mikesmitty/canbus-outpost/hardware/canbus-outpost/production/bom.csv

Comment | Designator | Footprint | LCSC
SS54 | D2,D6,D7,D8,D9,D10,D11,D12,D13,D14 | Library:D_SMA | C22452
TLV3202 | U6,U7,U8,U9 | Library:SOIC-8_3.9x4.9mm_P1.27mm | C129325
100nF | C1,C7,C8,C9,C11,C14,C15,C16,C20,C23,C25,C26,C27,C28,C29,C30,C31,C32,C33,C34,C35,C36,C37,C38,C39 | Library:C_0402_1005Metric | C1525
ISO7720D | U10,U12,U13,U14 | Package_SO:SOIC-8_3.9x4.9mm_P1.27mm | C486037
1R8 | R18,R19,R20,R21 | Library:R_1206_3216Metric | C15545
Green LED | D1 | Library:LED_0603_1608Metric | C965804
SERVO | J1 | Library:ServoHeader_3x04_2.54mm
USB | J9 | Library:PinHeader_1x04_P2.54mm_Vertical
10K | R2,R3,R8,R10 | Library:R_0402_1005Metric | C25744
15pF | C2,C5 | Library:C_0402_1005Metric | C1548
SN65HVD230 | U4 | Library:SOIC-8_3.9x4.9mm_P1.27mm | C12084
Blue LED | D15 | Library:LED_0603_1608Metric | C965807
1K | R1,R7,R11,R15,R17,R30,R31,R32,R33,R34,R37,R39,R41 | Library:R_0402_1005Metric | C11702
W25Q32JVSS | U1 | Library:SOIC-8_5.3x5.3mm_P1.27mm | C82344
1uF | C12 | Library:C_0603_1608Metric | C15849
3.24K | R9 | Library:R_0402_1005Metric | C11457
330K | R14,R16,R38,R40,R42 | Library:R_0402_1005Metric | C25778
EL3H4(A)(TA)-G | U15 | Package_SO:SOIC-4_4.55x2.6mm_P1.27mm | C42384998
BUTTON | SW1,SW2 | Library:SW_SPST_PTS810 | C139797
220uF | C10,C18,C22 | Library:CP_Elec_6.3x7.7 | C7471881
GPIO | J14 | Connector_PinHeader_2.54mm:PinHeader_1x08_P2.54mm_Vertical
L78L05_SO8 | U11 | Package_SO:SOIC-8_3.9x4.9mm_P1.27mm | C7543
3.3uH | L1 | Library:L_pol_2016 | C42411119
4.7uF | C3,C4 | Library:C_0402_1005Metric_small_pads | C23733
27R | R4,R5 | Library:R_0402_1005Metric | C25100
RJ45 | J10,J13 | Library:RJ45_Amphenol_54602-x08_Horizontal | C3000197
RP2350A | U2 | Library:QFN-60-1EP_7x7mm_P0.4mm_EP3.4x3.4mm | C42411118
BOOSTER | J3 | Library:PhoenixContact_MC_1,5_2-G-3.5_1x02_P3.50mm_Horizontal
10uF | C19,C21 | Library:C_0805_2012Metric | C15850
4.7uF | C6,C13 | Library:C_0402_1005Metric | C23733
VDC | J8 | Library:BarrelJack_Wuerth_694106106102_2.0x5.5mm | C319134
DCC_SIG | J2 | Library:JST_XH_S2B-XH-A_1x02_P2.50mm_Horizontal
4.7K | R36 | Library:R_0402_1005Metric | C25900
ABM8-272-T3 | Y1 | Library:Crystal_SMD_3225-4Pin_3.2x2.5mm | C20625731
5A | F1 | Library:Fuse_2920_7451Metric | C20539728
TRACK2 | J6 | Library:PhoenixContact_MC_1,5_2-G-3.5_1x02_P3.50mm_Horizontal
PWR_POS | JP3 | Jumper:SolderJumper-2_P1.3mm_Bridged_Pad1.0x1.5mm
XC6206PxxxMR | U5 | Library:SOT-23-3 | C5446
TRACK3 | J5 | Library:PhoenixContact_MC_1,5_2-G-3.5_1x02_P3.50mm_Horizontal
PWR_POS | JP1 | Connector_PinHeader_2.54mm:PinHeader_1x02_P2.54mm_Vertical
10nF | C17 | Library:C_0402_1005Metric | C15195
1N5819WS | D5 | Diode_SMD:D_SOD-323 | C191023
2.2K | R35 | Library:R_1206_3216Metric | C17948
15uH | L2 | Library:L_Changjiang_FXL0630 | C177243
TRACK1 | J7 | Library:PhoenixContact_MC_1,5_2-G-3.5_1x02_P3.50mm_Horizontal
TPS5430DDA | U3 | Library:TI_SO-PowerPAD-8_ThermalVias | C9864
33R | R6 | Library:R_0402_1005Metric | C25105
Red LED | D3 | Library:LED_0603_1608Metric | C2286
SWD | J11 | Library:PinHeader_1x03_P2.54mm_Vertical
TRACK4 | J4 | Library:PhoenixContact_MC_1,5_2-G-3.5_1x02_P3.50mm_Horizontal
PWR_NEG | JP2 | Jumper:SolderJumper-2_P1.3mm_Bridged_Pad1.0x1.5mm
