mikesmitty/canbus-outpost/hardware/canbus-outpost/54602-908LF.stp

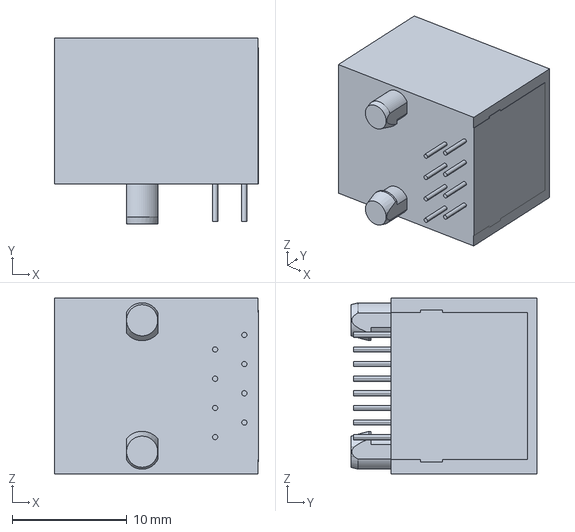
[picture p1: CAD file, 2025-09-01]
hardware/canbus-outpost/54602-908LF.stp
17.7 x 16.2 x 15.3 mm
