mikesmitty/canbus-outpost/hardware/canbus-outpost/CHANGELOG.md

# Changelog

## 0.4.0 (2026-11-13)

### Features

* add SSSB LED signal header ([7316e79](https://github.com/mikesmitty/canbus-outpost/commit/7316e792a6361132b21dae134f69fe599de6d2f2))
* add usb jack for flashing ([23d9043](https://github.com/mikesmitty/canbus-outpost/commit/23d90432513d269713aefd2f7569cba6d5ddb66d))
* initial commit ([35d93e9](https://github.com/mikesmitty/canbus-outpost/commit/35d93e993fa1c1821139c826e4c87451ff0ce4ea))

### Bug Fixes

* **hardware:** fix railcom circuits ([3e4cef5](https://github.com/mikesmitty/canbus-outpost/commit/3e4cef5458fc2f0919f649ae8a24d963a0a8edc6))
* switch from LM393 to TLV3202 for railcom signals ([46103d2](https://github.com/mikesmitty/canbus-outpost/commit/46103d206493b011c9451f2a776c54061438b2c6))
* update part rotations ([f5b980b](https://github.com/mikesmitty/canbus-outpost/commit/f5b980b29f2e95d8073f5162f05b1b61f52c5e41))
