mikesmitty/canbus-outpost/hardware/canbus-outpost/canbus-outpost.kicad_pcb

## KiCad design hardware/canbus-outpost/canbus-outpost.kicad_pcb (2026-11-13)

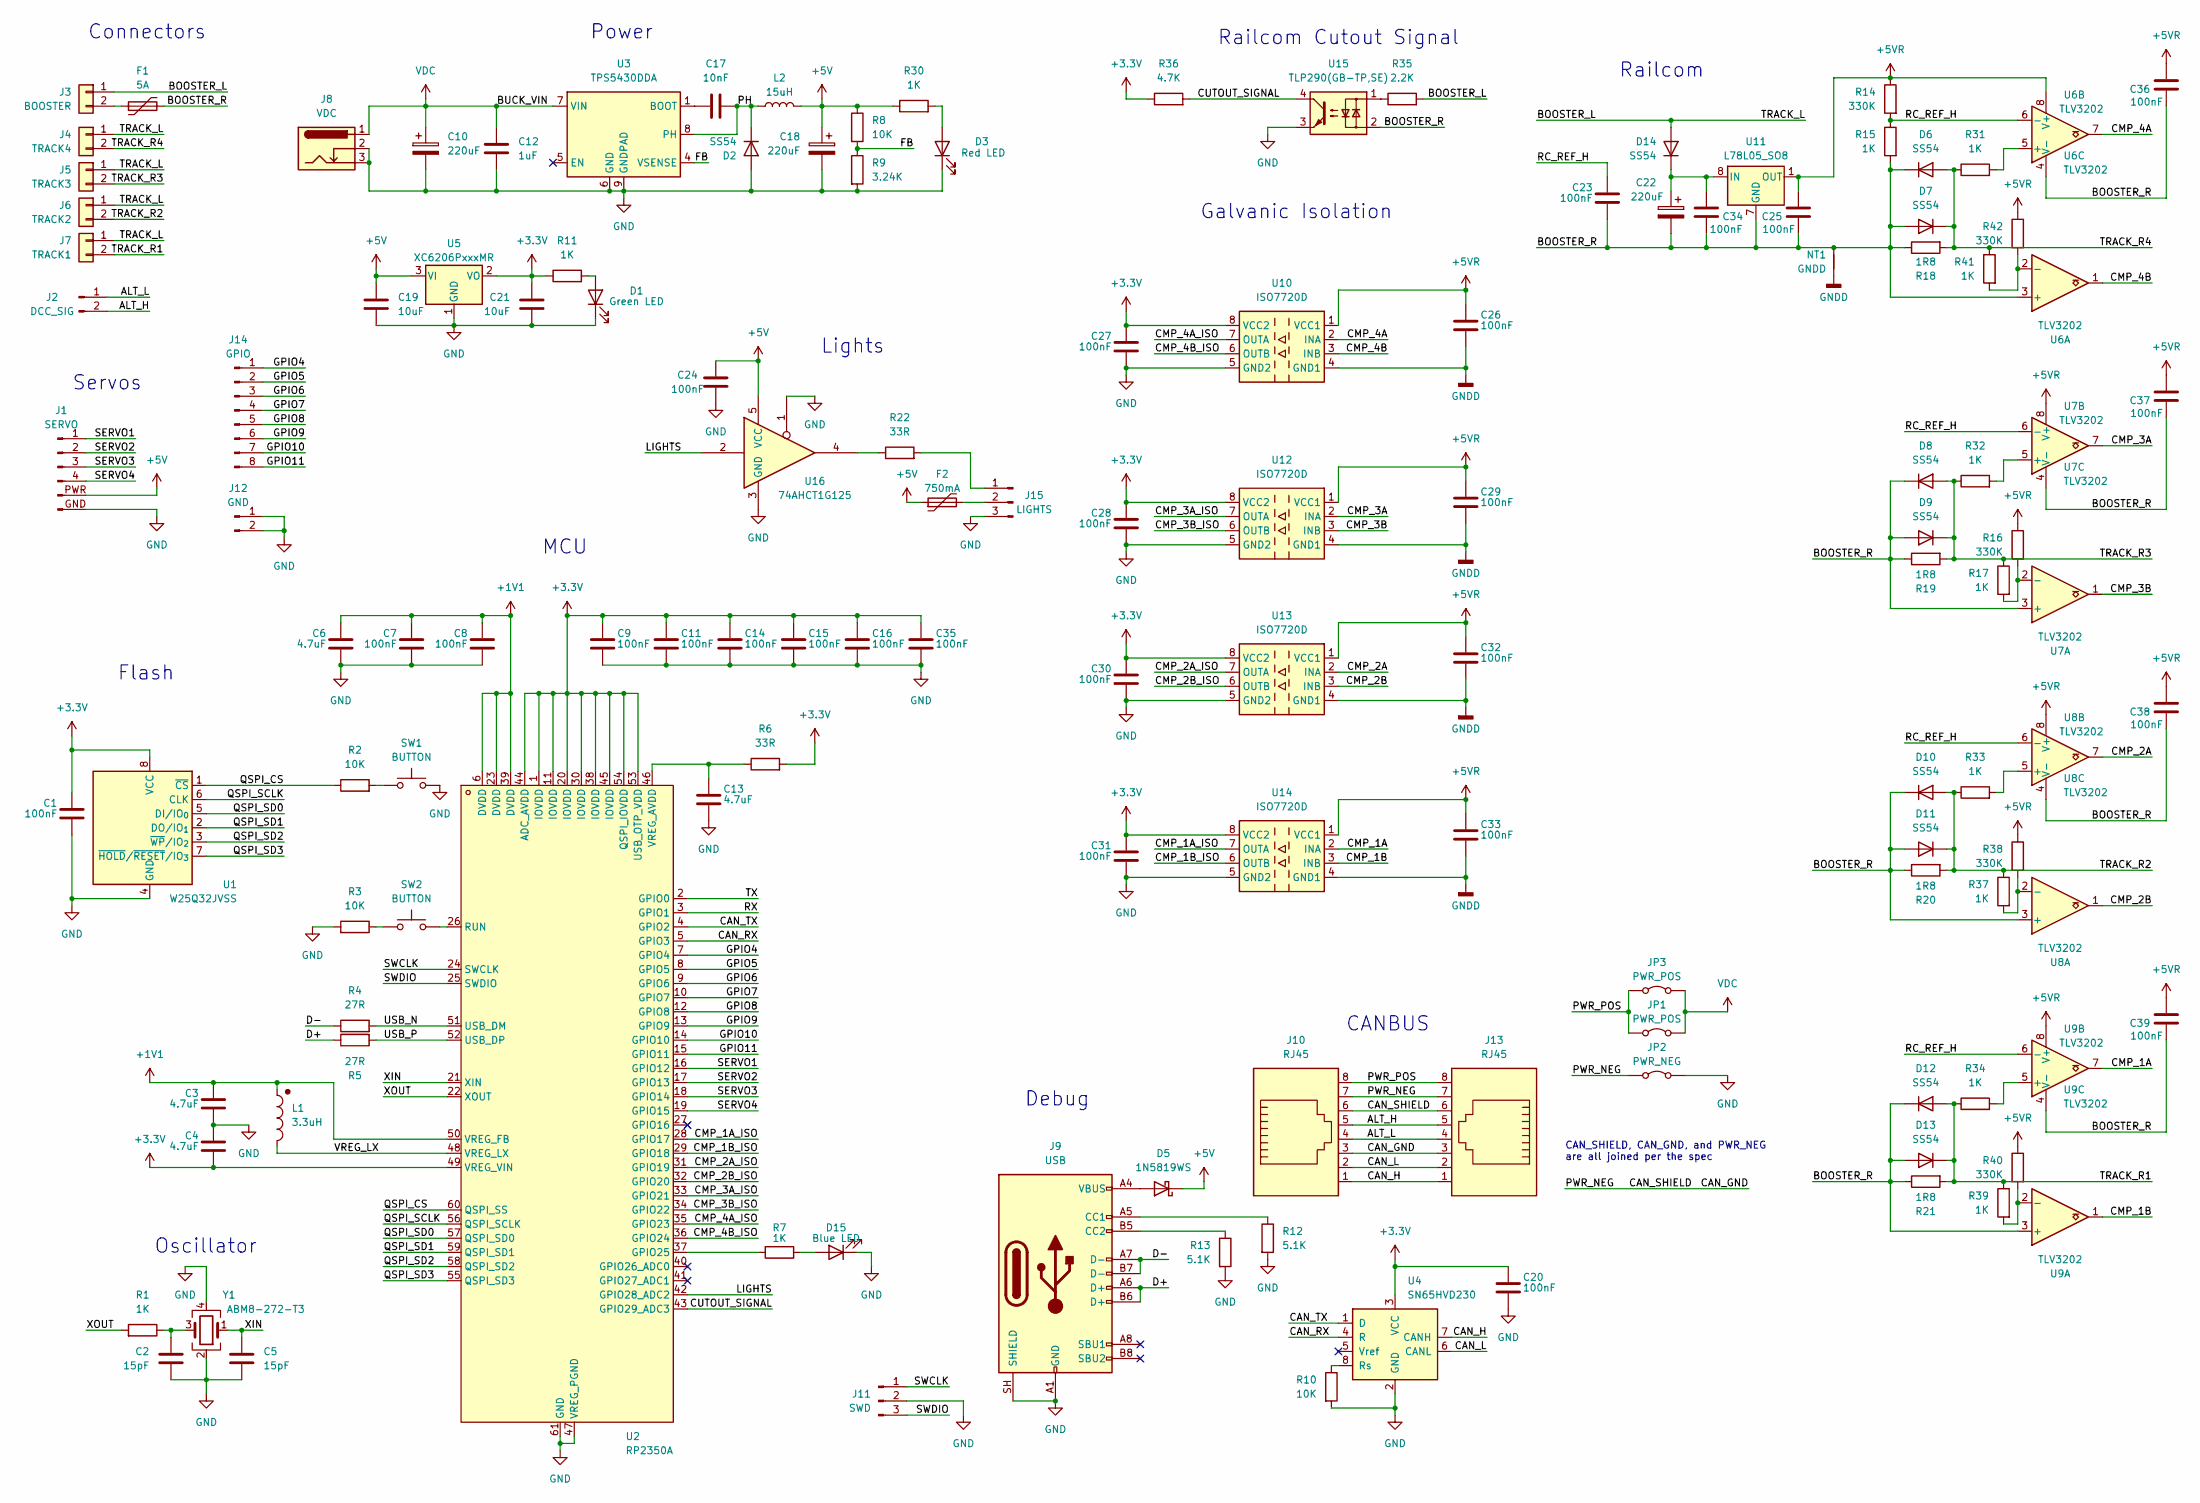
[picture p2: schematic canbus-outpost.kicad_sch, CANBUS Outpost]

Parts:
C1, C7, C8, C9, C11, C14, C15, C16, C20, C23, C24, C25, C26, C27, C28, C29, C30, C31, C32, C33, C34, C35, C36, C37, C38, C39: 100nF; C_0402_1005Metric; LCSC C1525
C2, C5: 15pF; C_0402_1005Metric; LCSC C1548
C3, C4: 4.7uF; C_0402_1005Metric_small_pads; LCSC C23733
C6, C13: 4.7uF; C_0402_1005Metric; LCSC C23733
C10, C18, C22: 220uF; CP_Elec_6.3x7.7; LCSC C7471881
C12: 1uF; C_0603_1608Metric; LCSC C15849
C17: 10nF; C_0402_1005Metric; LCSC C15195
C19, C21: 10uF; C_0805_2012Metric; LCSC C15850
D1: Green LED; LED_0603_1608Metric; LCSC C965804
D2, D6, D7, D8, D9, D10, D11, D12, D13, D14: SS54; D_SMA; LCSC C22452
D3: Red LED; LED_0603_1608Metric; LCSC C2286
D5: 1N5819WS; D_SOD-323; LCSC C191023
D15: Blue LED; LED_0603_1608Metric; LCSC C965807
F1: 5A; Fuse_2920_7451Metric; LCSC C20539728
F2: 750mA; Fuse_1206_3216Metric; LCSC C2830242
J1: SERVO; ServoHeader_3x04_2.54mm
J2: DCC_SIG; JST_XH_S2B-XH-A_1x02_P2.50mm_Horizontal
J3: BOOSTER; PhoenixContact_MC_1,5_2-G-3.5_1x02_P3.50mm_Horizontal
J4: TRACK4; PhoenixContact_MC_1,5_2-G-3.5_1x02_P3.50mm_Horizontal
J5: TRACK3; PhoenixContact_MC_1,5_2-G-3.5_1x02_P3.50mm_Horizontal
J6: TRACK2; PhoenixContact_MC_1,5_2-G-3.5_1x02_P3.50mm_Horizontal
J7: TRACK1; PhoenixContact_MC_1,5_2-G-3.5_1x02_P3.50mm_Horizontal
J8: VDC; BarrelJack_Wuerth_694106106102_2.0x5.5mm; LCSC C319134
J9: USB; USB_C_Receptacle_GCT_USB4115-03-C; LCSC C720628
J10, J13: RJ45; RJ45_Amphenol_54602-x08_Horizontal; LCSC C3000197
J11: SWD; PinHeader_1x03_P2.54mm_Vertical
J12: GND; PinHeader_1x02_P2.54mm_Vertical
J14: GPIO; PinHeader_1x08_P2.54mm_Vertical
J15: LIGHTS; PinHeader_1x03_P2.54mm_Vertical
JP1: PWR_POS; PinHeader_1x02_P2.54mm_Vertical
JP2: PWR_NEG; SolderJumper-2_P1.3mm_Bridged_Pad1.0x1.5mm
JP3: PWR_POS; SolderJumper-2_P1.3mm_Bridged_Pad1.0x1.5mm
L1: 3.3uH; L_pol_2016; LCSC C42411119
L2: 15uH; L_Changjiang_FXL0630; LCSC C177243
NT1: GNDD; NetTie-2_SMD_Pad0.5mm
R1, R7, R11, R15, R17, R30, R31, R32, R33, R34, R37, R39, R41: 1K; R_0402_1005Metric; LCSC C11702
R2, R3, R8, R10: 10K; R_0402_1005Metric; LCSC C25744
R4, R5: 27R; R_0402_1005Metric; LCSC C25100
R6, R22: 33R; R_0402_1005Metric; LCSC C25105
R9: 3.24K; R_0402_1005Metric; LCSC C11457
R12, R13: 5.1K; R_0402_1005Metric; LCSC C25905
R14, R16, R38, R40, R42: 330K; R_0402_1005Metric; LCSC C25778
R18, R19, R20, R21: 1R8; R_1206_3216Metric; LCSC C15545
R35: 2.2K; R_1206_3216Metric; LCSC C17948
R36: 4.7K; R_0402_1005Metric; LCSC C25900
SW1, SW2: BUTTON; SW_SPST_PTS810; LCSC C139797
U1: W25Q32JVSS; SOIC-8_5.3x5.3mm_P1.27mm; LCSC C179173
U2: RP2350A; QFN-60-1EP_7x7mm_P0.4mm_EP3.4x3.4mm; LCSC C42411118
U3: TPS5430DDA; TI_SO-PowerPAD-8_ThermalVias; LCSC C9864
U4: SN65HVD230; SOIC-8_3.9x4.9mm_P1.27mm; LCSC C12084
U5: XC6206PxxxMR; SOT-23-3; LCSC C5446
U6, U7, U8, U9: TLV3202; SOIC-8_3.9x4.9mm_P1.27mm; LCSC C129325
U10, U12, U13, U14: ISO7720D; SOIC-8_3.9x4.9mm_P1.27mm; LCSC C486037
U11: L78L05_SO8; SOIC-8_3.9x4.9mm_P1.27mm; LCSC C7543
U15: TLP290(GB-TP,SE); SOIC-4_4.55x2.6mm_P1.27mm; LCSC C73839
U16: 74AHCT1G125; SOT-23-5; LCSC C7484
Y1: ABM8-272-T3; Crystal_SMD_3225-4Pin_3.2x2.5mm; LCSC C20625731

Connections:
+1V1: C3.1, C6.1, C7.1, C8.1, L1.1, U2.6 (DVDD), U2.23 (DVDD), U2.39 (DVDD), U2.50 (VREG_FB)
+3.3V: C1.1, C4.2, C9.1, C11.1, C14.1, C15.1, C16.1, C20.1, C21.1, C27.1, C28.1, C30.1, C31.1, C35.1, R6.2, R11.1, R36.1, U1.8 (VCC), U2.1 (IOVDD), U2.11 (IOVDD), U2.20 (IOVDD), U2.30 (IOVDD), U2.38 (IOVDD), U2.44 (ADC_AVDD), U2.45 (IOVDD), U2.49 (VREG_VIN), U2.53 (USB_OTP_VDD), U2.54 (QSPI_IOVDD), U4.3 (VCC), U5.2 (VO), U10.8 (VCC2), U12.8 (VCC2), U13.8 (VCC2), U14.8 (VCC2)
+5V: C18.1, C19.1, C24.1, D5.1 (K), F2.1, J1.PWR (Pin_5), L2.2, R8.1, R30.1, U5.3 (VI), U16.5 (VCC)
+5VR: C25.1, C26.1, C29.1, C32.1, C33.1, C36.1, C37.1, C38.1, C39.1, R14.1, R16.1, R38.1, R40.1, R42.1, U6.8 (V+), U7.8 (V+), U8.8 (V+), U9.8 (V+), U10.1 (VCC1), U11.1 (OUT), U12.1 (VCC1), U13.1 (VCC1), U14.1 (VCC1)
/ALT_H: J2.2, J10.5, J13.5
/ALT_L: J2.1, J10.4, J13.4
/BOOSTER_L: D14.2 (A), J3.1, J4.1, J5.1, J6.1, J7.1, R35.2
/BOOSTER_R: C22.2, C23.2, C25.2, C34.2, C36.2, C37.2, C38.2, C39.2, D6.1 (K), D7.2 (A), D8.1 (K), D9.2 (A), D10.1 (K), D11.2 (A), D12.1 (K), D13.2 (A), F1.2, NT1.2, R15.2, R18.1, R19.1, R20.1, R21.1, U6.3 (+), U6.4 (V-), U7.3 (+), U7.4 (V-), U8.3 (+), U8.4 (V-), U9.3 (+), U9.4 (V-), U11.2 (GND), U11.3 (GND), U11.6 (GND), U11.7 (GND), U15.2
/CAN_GND: J10.3, J10.6, J10.7, J13.3, J13.6, J13.7, JP2.1 (A)
/CAN_H: J10.1, J13.1, U4.7 (CANH)
/CAN_L: J10.2, J13.2, U4.6 (CANL)
/CAN_RX: U2.5 (GPIO3), U4.4 (R)
/CAN_TX: U2.4 (GPIO2), U4.1 (D)
/CMP_1A: U9.7, U14.2 (INA)
/CMP_1A_ISO: U2.28 (GPIO17), U14.7 (OUTA)
/CMP_1B: U9.1, U14.3 (INB)
/CMP_1B_ISO: U2.29 (GPIO18), U14.6 (OUTB)
/CMP_2A: U8.7, U13.2 (INA)
/CMP_2A_ISO: U2.31 (GPIO19), U13.7 (OUTA)
/CMP_2B: U8.1, U13.3 (INB)
/CMP_2B_ISO: U2.32 (GPIO20), U13.6 (OUTB)
/CMP_3A: U7.7, U12.2 (INA)
/CMP_3A_ISO: U2.33 (GPIO21), U12.7 (OUTA)
/CMP_3B: U7.1, U12.3 (INB)
/CMP_3B_ISO: U2.34 (GPIO22), U12.6 (OUTB)
/CMP_4A: U6.7, U10.2 (INA)
/CMP_4A_ISO: U2.35 (GPIO23), U10.7 (OUTA)
/CMP_4B: U6.1, U10.3 (INB)
/CMP_4B_ISO: U2.36 (GPIO24), U10.6 (OUTB)
/CUTOUT_SIGNAL: R36.2, U2.43 (GPIO29_ADC3), U15.4
/D+: J9.A6 (D+), J9.B6 (D+), R5.1
/D-: J9.A7 (D-), J9.B7 (D-), R4.1
/FB: R8.2, R9.1, U3.4 (VSENSE)
/GPIO4: J14.1, U2.7 (GPIO4)
/GPIO5: J14.2, U2.8 (GPIO5)
/GPIO6: J14.3, U2.9 (GPIO6)
/GPIO7: J14.4, U2.10 (GPIO7)
/GPIO8: J14.5, U2.12 (GPIO8)
/GPIO9: J14.6, U2.13 (GPIO9)
/GPIO10: J14.7, U2.14 (GPIO10)
/GPIO11: J14.8, U2.15 (GPIO11)
/LIGHTS: U2.42 (GPIO28_ADC2), U16.2
/PH: C17.2, D2.1 (K), L2.1, U3.8 (PH)
/PWR_POS: J10.8, J13.8, JP1.1 (A), JP3.1 (A)
/QSPI_CS: R2.1, U1.1 (~CS), U2.60 (QSPI_SS)
/QSPI_SCLK: U1.6 (CLK), U2.56 (QSPI_SCLK)
/QSPI_SD0: U1.5 (DI/IO_{0}), U2.57 (QSPI_SD0)
/QSPI_SD1: U1.2 (DO/IO_{1}), U2.59 (QSPI_SD1)
/QSPI_SD2: U1.3 (~WP/IO_{2}), U2.58 (QSPI_SD2)
/QSPI_SD3: U1.7 (~HOLD/~RESET/IO_{3}), U2.55 (QSPI_SD3)
/RC_REF_H: C23.1, R14.2, R15.1, U6.6 (-), U7.6 (-), U8.6 (-), U9.6 (-)
/RX: U2.3 (GPIO1)
/SERVO1: J1.1, U2.16 (GPIO12)
/SERVO2: J1.2, U2.17 (GPIO13)
/SERVO3: J1.3, U2.18 (GPIO14)
/SERVO4: J1.4, U2.19 (GPIO15)
/SWCLK: J11.1, U2.24 (SWCLK)
/SWDIO: J11.3, U2.25 (SWDIO)
/TRACK_R1: D12.2 (A), D13.1 (K), J7.2, R21.2, R34.1, R39.1
/TRACK_R2: D10.2 (A), D11.1 (K), J6.2, R20.2, R33.1, R37.1
/TRACK_R3: D8.2 (A), D9.1 (K), J5.2, R17.1, R19.2, R32.1
/TRACK_R4: D6.2 (A), D7.1 (K), J4.2, R18.2, R31.1, R41.1
/TX: U2.2 (GPIO0)
/USB_N: R4.2, U2.51 (USB_DM)
/USB_P: R5.2, U2.52 (USB_DP)
/VREG_LX: L1.2, U2.48 (VREG_LX)
/XIN: C5.1, U2.21 (XIN), Y1.1
/XOUT: R1.2, U2.22 (XOUT)
GND: C1.2, C2.2, C3.2, C4.1, C5.2, C6.2, C7.2, C8.2, C9.2, C10.2, C11.2, C12.2, C13.2, C14.2, C15.2, C16.2, C18.2, C19.2, C20.2, C21.2, C24.2, C27.2, C28.2, C30.2, C31.2, C35.2, D1.1 (K), D2.2 (A), D3.1 (K), D15.1 (K), J1.GND (Pin_6), J8.2, J8.3, J9.A1 (GND), J9.A12 (GND), J9.B1 (GND), J9.B12 (GND), J9.SH (SHIELD), J11.2, J12.1, J12.2, J15.3, JP2.2 (B), R3.2, R9.2, R10.2, R12.2, R13.2, SW1.2, U1.4 (GND), U2.47 (VREG_PGND), U2.61 (GND), U3.6 (GND), U3.9 (GNDPAD), U4.2 (GND), U5.1 (GND), U10.5 (GND2), U12.5 (GND2), U13.5 (GND2), U14.5 (GND2), U15.3, U16.1, U16.3 (GND), Y1.2, Y1.4
GNDD: C26.2, C29.2, C32.2, C33.2, NT1.1, U10.4 (GND1), U12.4 (GND1), U13.4 (GND1), U14.4 (GND1)
unnamed: C2.1, R1.1, Y1.3
unnamed: D1.2 (A), R11.2
unnamed: D3.2 (A), R30.2
unnamed: D5.2 (A), J9.A4 (VBUS), J9.A9 (VBUS), J9.B4 (VBUS), J9.B9 (VBUS)
unnamed: C22.1, C34.1, D14.1 (K), U11.8 (IN)
unnamed: D15.2 (A), R7.1
unnamed: F1.1, J3.2
unnamed: J9.A5 (CC1), R12.1
unnamed: J9.B5 (CC2), R13.1
unnamed: J15.1, R22.2
unnamed: F2.2, J15.2
unnamed: R2.2, SW1.1
unnamed: R3.1, SW2.2
unnamed: R22.1, U16.4
unnamed: R35.1, U15.1
unnamed: R7.2, U2.37 (GPIO25)
unnamed: SW2.1, U2.26 (RUN)
unnamed: C13.1, R6.1, U2.46 (VREG_AVDD)
unnamed: C17.1, U3.1 (BOOT)
unnamed: R10.1, U4.8 (Rs)
unnamed: R41.2, R42.2, U6.2 (-)
unnamed: R31.2, U6.5 (+)
unnamed: R16.2, R17.2, U7.2 (-)
unnamed: R32.2, U7.5 (+)
unnamed: R37.2, R38.2, U8.2 (-)
unnamed: R33.2, U8.5 (+)
unnamed: R39.2, R40.2, U9.2 (-)
unnamed: R34.2, U9.5 (+)
VDC: C10.1, C12.1, J8.1, JP1.2 (B), JP3.2 (B), U3.7 (VIN)

Notes on the sheet:
Oscillator
Lights
Railcom
CAN_SHIELD, CAN_GND, and PWR_NEG are all joined per the spec
Galvanic Isolation
MCU
Railcom Cutout Signal
Debug
Servos
Flash
Connectors
Power
CANBUS

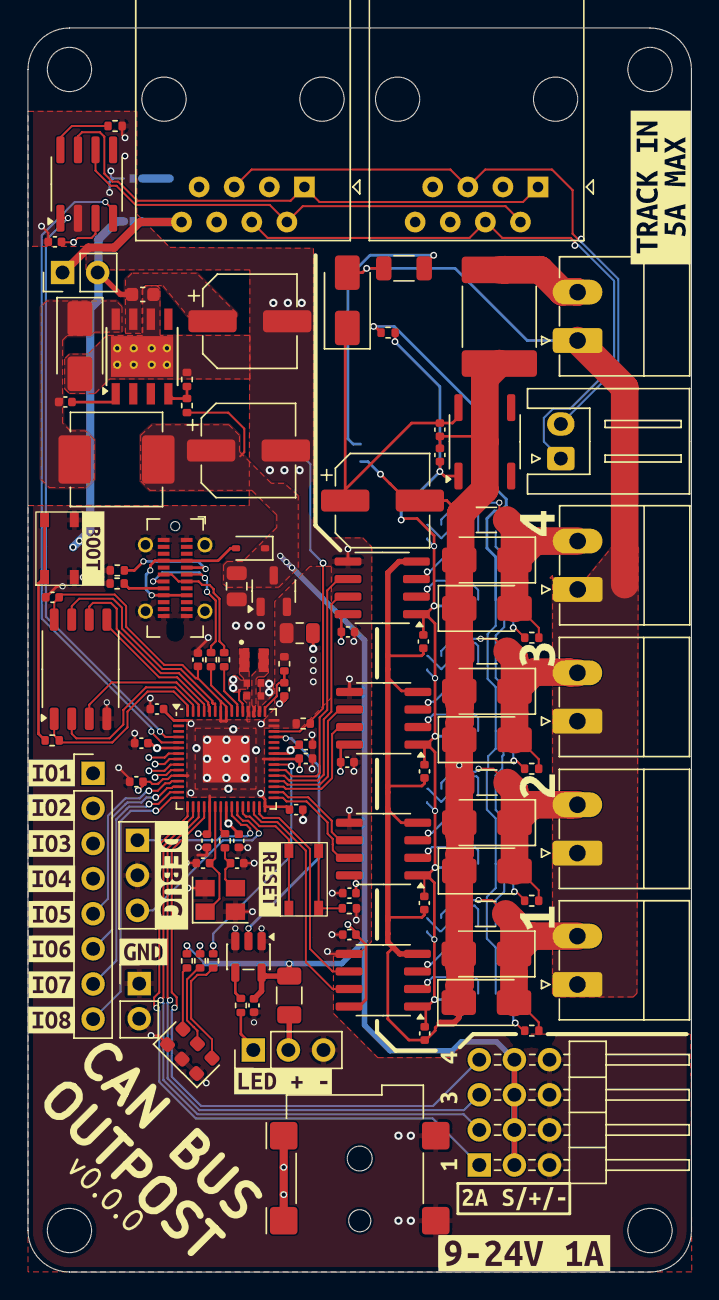
[picture p3: board canbus-outpost.kicad_pcb from above]

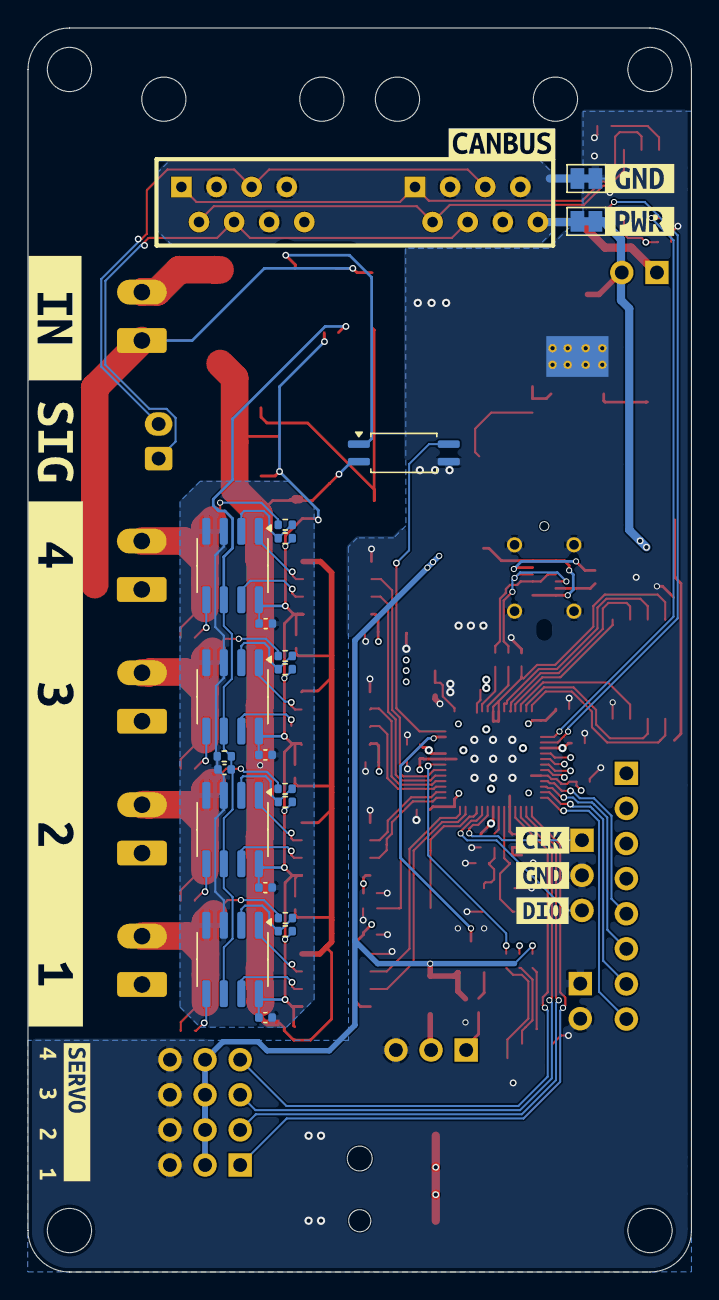
[picture p4: board canbus-outpost.kicad_pcb from below]

Board: 4 copper layers, 48.0 x 90.0 mm, 162 parts (32 on the bottom side), 97 nets.

Other parts of the board:
kibuzzard-6AE53D03: G***; kibuzzard-6AE53D03
kibuzzard-6AE558B7: G***; kibuzzard-6AE558B7
kibuzzard-69DC4DF3: G***; kibuzzard-69DC4DF3
kibuzzard-69DC4DFC: G***; kibuzzard-69DC4DFC
kibuzzard-69DC4E0F: G***; kibuzzard-69DC4E0F
kibuzzard-69DC4E03: G***; kibuzzard-69DC4E03
kibuzzard-69DC490B: G***; kibuzzard-69DC490B
kibuzzard-69DC492A: G***; kibuzzard-69DC492A
kibuzzard-69DC4912: G***; kibuzzard-69DC4912
kibuzzard-69DC4921: G***; kibuzzard-69DC4921
kibuzzard-688B6E49: G***; kibuzzard-688B6E49
kibuzzard-688B6E90: G***; kibuzzard-688B6E90
kibuzzard-688B7D39: G***; kibuzzard-688B7D39
kibuzzard-688B72C3: G***; kibuzzard-688B72C3
kibuzzard-688B73DB: G***; kibuzzard-688B73DB
kibuzzard-688B7055: G***; kibuzzard-688B7055
kibuzzard-688B7428: G***; kibuzzard-688B7428
kibuzzard-688B7622: G***; kibuzzard-688B7622
kibuzzard-688B7949: G***; kibuzzard-688B7949
kibuzzard-688BEB22: G***; kibuzzard-688BEB22
kibuzzard-688BEC68: G***; kibuzzard-688BEC68
kibuzzard-688BEEB4: G***; kibuzzard-688BEEB4
kibuzzard-688BF0B8: G***; kibuzzard-688BF0B8
kibuzzard-688BF0BD: G***; kibuzzard-688BF0BD
kibuzzard-688D2D9A: G***; kibuzzard-688D2D9A
kibuzzard-688D2D45: G***; kibuzzard-688D2D45
kibuzzard-688D2DB6: G***; kibuzzard-688D2DB6
kibuzzard-688D2DD7: G***; kibuzzard-688D2DD7
kibuzzard-688D2F72: G***; kibuzzard-688D2F72
kibuzzard-688D2FE4: G***; kibuzzard-688D2FE4
kibuzzard-688D37AD: G***; kibuzzard-688D37AD
kibuzzard-688D3063: G***; kibuzzard-688D3063
