mikesmitty/canbus-outpost/hardware/sssb-single/sssb-single.kicad_pcb

## KiCad design hardware/sssb-single/sssb-single.kicad_pcb (2026-11-13)

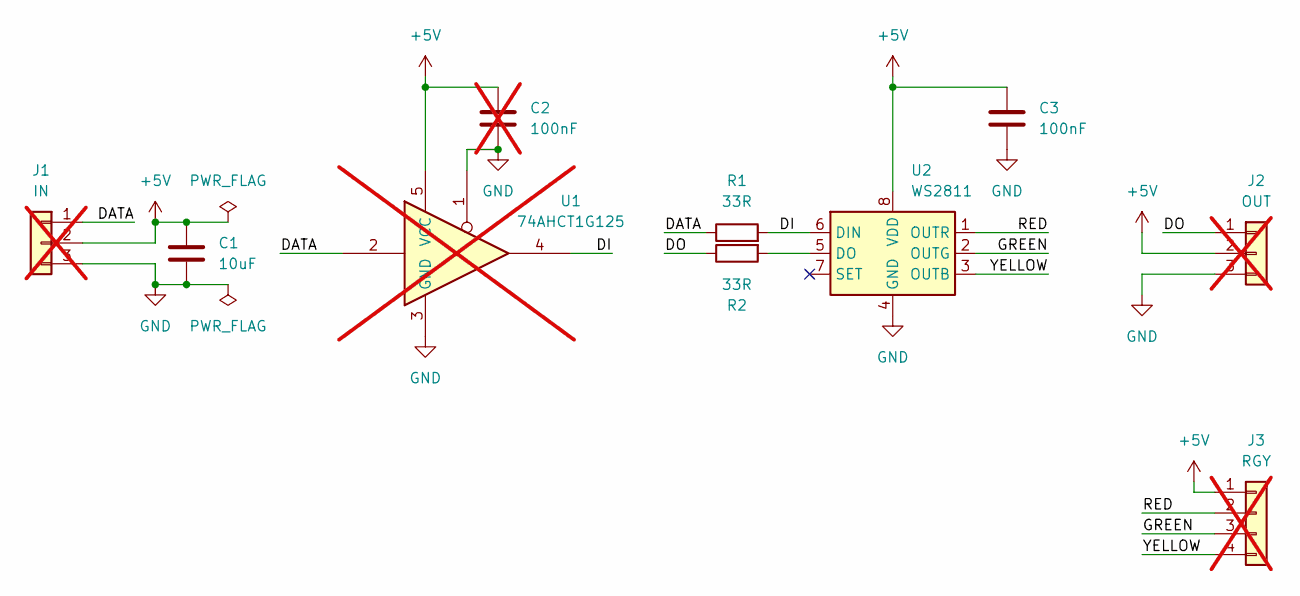
[picture p5: schematic sssb-single.kicad_sch, SSSB Single]

Parts:
C1: 10uF; C_0805_2012Metric; LCSC C15850
C2: 100nF; C_0805_2012Metric; LCSC C49678; not fitted
C3: 100nF; C_0805_2012Metric; LCSC C49678
J1: IN; PinHeader_1x03_P2.54mm_Vertical; not fitted
J2: OUT; PinHeader_1x03_P2.54mm_Vertical; not fitted
J3: RGY; PinHeader_1x04_P2.54mm_Vertical; not fitted
R1, R2: 33R; R_0805_2012Metric; LCSC C17634
U1: 74AHCT1G125; SOT-23-5; not fitted
U2: WS2811; SOIC-8_3.9x4.9mm_P1.27mm; LCSC C114581

Connections:
+5V: C1.1, C2.1, C3.1, J1.2, J2.2, J3.1, U1.5 (VCC), U2.8 (VDD)
/DATA: J1.1, R1.1, U1.2
/DI: R1.2, U1.4, U2.6 (DIN)
/DO: J2.1, R2.1
/GREEN: J3.3, U2.2 (OUTG)
/RED: J3.2, U2.1 (OUTR)
/YELLOW: J3.4, U2.3 (OUTB)
GND: C1.2, C2.2, C3.2, J1.3, J2.3, U1.1, U1.3 (GND), U2.4 (GND)
unnamed: R2.2, U2.5 (DO)

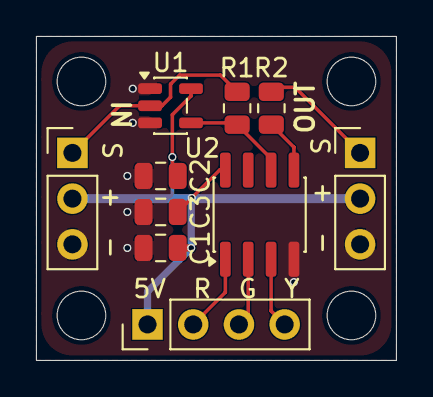
[picture p6: board sssb-single.kicad_pcb from above]

Board: 2 copper layers, 20.0 x 18.0 mm, 10 parts (0 on the bottom side), 9 nets.
