mikesmitty/canbus-outpost/src/board.h

#ifndef BOARD_H
#define BOARD_H

#include "pico/stdlib.h"

// Debug UART0
#define DEBUG_UART uart0
#define DEBUG_TX_PIN 0
#define DEBUG_RX_PIN 1

// CAN Bus (PIO)
#define CAN_TX_PIN 2
#define CAN_RX_PIN 3

// General Purpose I/O
#define GPIO_OUT1 4
#define GPIO_OUT2 5
#define GPIO_OUT3 6
#define GPIO_OUT4 7

#define GPIO_IN1 8
#define GPIO_IN2 9
#define GPIO_IN3 10
#define GPIO_IN4 11

// Servo PWM Outputs
#define SERVO1_PIN 12
#define SERVO2_PIN 13
#define SERVO3_PIN 14
#define SERVO4_PIN 15

// RailCom Detector Channels (A and B for Data/Orientation)
// Channel n is the TRACK_Rn block. A is high while current flows from the
// rail into BOOSTER_R, B while it flows the other way; both low when idle.
#define RC_CH1_A 17
#define RC_CH1_B 18
#define RC_CH2_A 19
#define RC_CH2_B 20
#define RC_CH3_A 21
#define RC_CH3_B 22
#define RC_CH4_A 23
#define RC_CH4_B 24

// RailCom cutout: high while the booster holds the cutout (U15 opto)
#define RC_CUTOUT_PIN 29

// The RailCom PIO samples 16 consecutive GPIOs starting here; all RC_* pins
// must fall within that range.
#define RC_SAMPLE_BASE_PIN 17

// Signal lights: a WS2811 chain on the LED header (J15)
#define LIGHTS_PIN 28

// Board identify LED
#ifndef PICO_DEFAULT_LED_PIN
#define IDENTIFY_LED_PIN 25
#else
#define IDENTIFY_LED_PIN PICO_DEFAULT_LED_PIN
#endif

#endif // BOARD_H
