mikesmitty/canbus-outpost/src/app/cdi_data.c

#include "cdi_data.h"

#define HEAD(n) "<repname>Head " #n "</repname>"
/* Not just "Head n": tools that name a replica by its repname alone would
 * mix these up with the heads */
#define OUTPUTS(n) "<repname>Head " #n " Outputs</repname>"

#define PHASE_MAP \
    "<map>" \
    "<relation><property>0</property><value>A</value></relation>" \
    "<relation><property>1</property><value>B</value></relation>" \
    "</map>"

#define LAMP_MAP \
    "<map>" \
    "<relation><property>0</property><value>None</value></relation>" \
    "<relation><property>1</property><value>Red</value></relation>" \
    "<relation><property>2</property><value>Yellow</value></relation>" \
    "<relation><property>3</property><value>Green</value></relation>" \
    "<relation><property>4</property><value>Lunar</value></relation>" \
    "<relation><property>5</property><value>S</value></relation>" \
    "<relation><property>6</property><value>D</value></relation>" \
    "<relation><property>7</property><value>Number</value></relation>" \
    "<relation><property>8</property><value>Own Events</value></relation>" \
    "</map>"

const char cdi_xml[] =
    "<?xml version='1.0' encoding='UTF-8'?>"
    "<cdi xmlns:xsi='http://www.w3.org/2001/XMLSchema-instance'"
    " xsi:noNamespaceSchemaLocation='https://openlcb.org/schema/cdi/1/4/cdi.xsd'>"

    "<identification>"
    "<manufacturer>mikesmitty</manufacturer>"
    "<model>CAN Bus Outpost</model>"
    "<hardwareVersion>Rev A</hardwareVersion>"
    "<!-- x-release-please-start-version -->"
    "<softwareVersion>0.6.0</softwareVersion>"
    "<!-- x-release-please-end -->"
    "</identification>"

    "<segment space='253' origin='0'>"
    "<name>Node Identity</name>"
    "<string size='64'><name>User Name</name></string>"
    "<string size='64'><name>User Description</name></string>"
    "</segment>"

    "<segment space='253' origin='128'>"
    "<name>Identify</name>"
    "<int size='1'>"
    "<name>Enabled</name>"
    "<default>0</default>"
    "<map>"
    "<relation><property>0</property><value>Disabled</value></relation>"
    "<relation><property>1</property><value>Enabled</value></relation>"
    "</map>"
    "</int>"
    "<int size='1'>"
    "<name>LED Timeout</name>"
    "<description>How long the identify LED flashes before turning off</description>"
    "<default>5</default>"
    "<map>"
    "<relation><property>0</property><value>Indefinite</value></relation>"
    "<relation><property>1</property><value>1 minute</value></relation>"
    "<relation><property>5</property><value>5 minutes</value></relation>"
    "<relation><property>10</property><value>10 minutes</value></relation>"
    "<relation><property>15</property><value>15 minutes</value></relation>"
    "</map>"
    "</int>"
    "</segment>"

    "<segment space='253' origin='132'>"
    "<name>Switch Machines</name>"
    "<group replication='4'>"
    "<name>Servo</name>"
    "<repname>Servo 1</repname>"
    "<repname>Servo 2</repname>"
    "<repname>Servo 3</repname>"
    "<repname>Servo 4</repname>"

    "<eventid><name>Throw Command Event</name></eventid>"
    "<eventid><name>Close Command Event</name></eventid>"
    "<eventid><name>Thrown Feedback Event</name></eventid>"
    "<eventid><name>Closed Feedback Event</name></eventid>"
    "<eventid><name>Center Command Event</name></eventid>"

    "<int size='2'>"
    "<name>Thrown Position</name>"
    "<description>PWM position when thrown (0-65535)</description>"
    "<min>0</min><max>65535</max><default>16384</default>"
    "</int>"
    "<int size='2'>"
    "<name>Closed Position</name>"
    "<description>PWM position when closed (0-65535)</description>"
    "<min>0</min><max>65535</max><default>49152</default>"
    "</int>"
    "<int size='2'>"
    "<name>Center Position</name>"
    "<description>PWM position when centering for installation (0-65535)</description>"
    "<min>0</min><max>65535</max><default>32768</default>"
    "</int>"
    "<int size='1'>"
    "<name>Throw Time</name>"
    "<description>Throw duration in tenths of a second (0=instant, 30=3.0s)</description>"
    "<min>0</min><max>255</max><default>30</default>"
    "</int>"
    "<int size='1'>"
    "<name>Hold Time</name>"
    "<description>Seconds to hold position after throw before cutting power (0=hold forever)</description>"
    "<min>0</min><max>255</max><default>2</default>"
    "</int>"
    "<int size='1'>"
    "<name>Enabled</name>"
    "<default>1</default>"
    "<map>"
    "<relation><property>0</property><value>Disabled</value></relation>"
    "<relation><property>1</property><value>Enabled</value></relation>"
    "</map>"
    "</int>"
    "<int size='1'>"
    "<name>Default State</name>"
    "<description>Position at power-on</description>"
    "<default>1</default>"
    "<map>"
    "<relation><property>0</property><value>Thrown</value></relation>"
    "<relation><property>1</property><value>Closed</value></relation>"
    "<relation><property>2</property><value>No Change</value></relation>"
    "</map>"
    "</int>"
    "<int size='1'>"
    "<name>Reversed</name>"
    "<description>Swap thrown/closed direction</description>"
    "<default>0</default>"
    "<map>"
    "<relation><property>0</property><value>Normal</value></relation>"
    "<relation><property>1</property><value>Reversed</value></relation>"
    "</map>"
    "</int>"
    "<int size='1'>"
    "<name>Frog Output</name>"
    "<description>GP Output to toggle for frog polarity</description>"
    "<default>0</default>"
    "<map>"
    "<relation><property>0</property><value>None</value></relation>"
    "<relation><property>1</property><value>Output 1 (GPIO 4)</value></relation>"
    "<relation><property>2</property><value>Output 2 (GPIO 5)</value></relation>"
    "<relation><property>3</property><value>Output 3 (GPIO 6)</value></relation>"
    "<relation><property>4</property><value>Output 4 (GPIO 7)</value></relation>"
    "</map>"
    "</int>"
    "<int size='1'>"
    "<name>Fascia Input</name>"
    "<description>GP Input for local manual control</description>"
    "<default>0</default>"
    "<map>"
    "<relation><property>0</property><value>None</value></relation>"
    "<relation><property>1</property><value>Input 1</value></relation>"
    "<relation><property>2</property><value>Input 2</value></relation>"
    "<relation><property>3</property><value>Input 3</value></relation>"
    "<relation><property>4</property><value>Input 4</value></relation>"
    "</map>"
    "</int>"

    "<string size='64'><name>Description</name></string>"

    "<string size='3'/>" /* pad to multiple of 8 */

    "</group>"
    "</segment>"

    "<segment space='253' origin='612'>"
    "<name>RailCom Detectors</name>"
    "<description>Each track reports the RailCom decoders seen on it. Only locomotives "
    "and cars whose decoders send RailCom are detected.</description>"
    "<group replication='4'>"
    "<name>Track</name>"
    "<repname>Track 1</repname>"
    "<repname>Track 2</repname>"
    "<repname>Track 3</repname>"
    "<repname>Track 4</repname>"

    "<string size='64'><name>Description</name></string>"
    "<eventid><name>Occupied Event</name>"
    "<description>Sent when a RailCom decoder is detected on the track</description></eventid>"
    "<eventid><name>Clear Event</name>"
    "<description>Sent when no decoder has been seen on the track for a second</description></eventid>"
    "<eventid><name>Reporter ID</name>"
    "<description>Reports which locomotive is on the track (OpenLCB DCC detector events). "
    "Enter this as the address of a JMRI LCC Reporter. It must be a unique ID of its own "
    "with 00.00 at the end; all zeros turns reporting off.</description></eventid>"
    "<int size='1'>"
    "<name>Orientation</name>"
    "<description>Whether reports say which way a locomotive faces. Rail A is positive in "
    "the first half of each DCC bit; the detector senses the TRACK_R rail. If JMRI shows "
    "locomotives facing the wrong way, choose the other rail.</description>"
    "<default>0</default>"
    "<map>"
    "<relation><property>0</property><value>Not reported</value></relation>"
    "<relation><property>1</property><value>TRACK_R is Rail A</value></relation>"
    "<relation><property>2</property><value>TRACK_R is Rail B</value></relation>"
    "</map>"
    "</int>"
    "<string size='7'/>" /* room for more settings */

    "</group>"
    "</segment>"

    "<segment space='253' origin='996'>"
    "<name>Signal Heads</name>"
    "<description>The signal heads on the SSSB chain, one WS2811 chip per head. Head 1 is the "
    "first on the cable from the board, unless its Chain Position says otherwise. Every chip on "
    "the cable needs to be there for the ones after it to work, in use or not.</description>"
    "<int size='1'>"
    "<name>Chain Speed</name>"
    "<description>Must match the SET pin of every chip on the chain: 800 kHz when open, "
    "400 kHz when tied to power</description>"
    "<default>0</default>"
    "<map>"
    "<relation><property>0</property><value>800 kHz</value></relation>"
    "<relation><property>1</property><value>400 kHz</value></relation>"
    "</map>"
    "</int>"
    "<int size='1'>"
    "<name>Connected To</name>"
    "<description>Where the chain plugs into the board. Boards made before the LED header "
    "was added can use a servo output instead, with a 5 V buffer on the data line. That "
    "servo's switch machine is then out of use, as if disabled.</description>"
    "<default>0</default>"
    "<map>"
    "<relation><property>0</property><value>LED header</value></relation>"
    "<relation><property>1</property><value>Servo 1</value></relation>"
    "<relation><property>2</property><value>Servo 2</value></relation>"
    "<relation><property>3</property><value>Servo 3</value></relation>"
    "<relation><property>4</property><value>Servo 4</value></relation>"
    "</map>"
    "</int>"
    "<string size='2'/>" /* room for more settings */

    "<group replication='16'>"
    "<name>Head</name>"
    "<description>A head is one chip with a lamp on each of its three outputs, R, G and Y, "
    "named as on an SSSB head's RGY header. Any lamp can go on any output. A head lights "
    "one kind of lamp at a time. A light that shows alongside another, like lunar under a red, "
    "needs a chip of its own: use the next head for it. Only the events for lamps this head "
    "has are on the bus. An output set to Own Events isn't part of the aspects: it has its own "
    "On and Off events, under Own Events below, for panel or building lights or lamps that "
    "light together.</description>"
    HEAD(1) HEAD(2) HEAD(3) HEAD(4) HEAD(5) HEAD(6) HEAD(7) HEAD(8)
    HEAD(9) HEAD(10) HEAD(11) HEAD(12) HEAD(13) HEAD(14) HEAD(15) HEAD(16)

    "<string size='32'><name>Description</name></string>"
    "<eventid><name>Dark Event</name></eventid>"
    "<eventid><name>Red Event</name></eventid>"
    "<eventid><name>Yellow Event</name></eventid>"
    "<eventid><name>Green Event</name></eventid>"
    "<eventid><name>Lunar Event</name></eventid>"
    "<eventid><name>S Event</name></eventid>"
    "<eventid><name>D Event</name></eventid>"
    "<eventid><name>Number Event</name></eventid>"
    "<eventid><name>Flashing Red Event</name></eventid>"
    "<eventid><name>Flashing Yellow Event</name></eventid>"
    "<eventid><name>Flashing Green Event</name></eventid>"

    "<int size='1'>"
    "<name>Enabled</name>"
    "<description>A disabled head stays dark and its events are off the bus</description>"
    "<default>0</default>"
    "<map>"
    "<relation><property>0</property><value>Disabled</value></relation>"
    "<relation><property>1</property><value>Enabled</value></relation>"
    "</map>"
    "</int>"
    "<int size='1'>"
    "<name>Power-On Aspect</name>"
    "<default>1</default>"
    "<map>"
    "<relation><property>0</property><value>Dark</value></relation>"
    "<relation><property>1</property><value>Red</value></relation>"
    "<relation><property>2</property><value>Yellow</value></relation>"
    "<relation><property>3</property><value>Green</value></relation>"
    "<relation><property>4</property><value>Lunar</value></relation>"
    "<relation><property>5</property><value>S</value></relation>"
    "<relation><property>6</property><value>D</value></relation>"
    "<relation><property>7</property><value>Number</value></relation>"
    "<relation><property>8</property><value>Flashing Red</value></relation>"
    "<relation><property>9</property><value>Flashing Yellow</value></relation>"
    "<relation><property>10</property><value>Flashing Green</value></relation>"
    "</map>"
    "</int>"
    "<int size='1'>"
    "<name>R Lamp</name>"
    "<default>1</default>"
    LAMP_MAP
    "</int>"
    "<int size='1'>"
    "<name>G Lamp</name>"
    "<default>3</default>"
    LAMP_MAP
    "</int>"
    "<int size='1'>"
    "<name>Y Lamp</name>"
    "<default>2</default>"
    LAMP_MAP
    "</int>"
    "<int size='1'>"
    "<name>R Brightness</name>"
    "<min>0</min><max>255</max><default>128</default>"
    "</int>"
    "<int size='1'>"
    "<name>G Brightness</name>"
    "<min>0</min><max>255</max><default>128</default>"
    "</int>"
    "<int size='1'>"
    "<name>Y Brightness</name>"
    "<min>0</min><max>255</max><default>128</default>"
    "</int>"
    "<int size='1'>"
    "<name>Lamp Fade</name>"
    "<description>Incandescent: lamps warm up and cool down like ballasted bulbs, flashing "
    "included, instead of switching at once</description>"
    "<default>0</default>"
    "<map>"
    "<relation><property>0</property><value>None</value></relation>"
    "<relation><property>1</property><value>Incandescent</value></relation>"
    "</map>"
    "</int>"
    "<int size='1'>"
    "<name>Chain Position</name>"
    "<description>Which chip on the chain shows this head, 1 being the first from the board. "
    "0 means the head's own number. After adding a chip partway along the chain, move the "
    "heads after it along by one here instead of setting them all up again. Two heads on "
    "one chip both show on it.</description>"
    "<min>0</min><max>16</max><default>0</default>"
    "</int>"
    "<int size='1'>"
    "<name>Flash Rate</name>"
    "<description>How fast the flashing aspects flash</description>"
    "<default>0</default>"
    "<map>"
    "<relation><property>1</property><value>Slow, 40 a minute</value></relation>"
    "<relation><property>0</property><value>Medium, 60 a minute</value></relation>"
    "<relation><property>2</property><value>Fast, 90 a minute</value></relation>"
    "</map>"
    "</int>"
    "<int size='1'>"
    "<name>R Phase</name>"
    "<description>When a flashing lamp on this output is lit. Phase B lamps light while "
    "phase A lamps are dark, so two lamps can alternate like a crossing flasher, on one "
    "head or two at the same rate.</description>"
    "<default>0</default>"
    PHASE_MAP
    "</int>"
    "<int size='1'>"
    "<name>G Phase</name>"
    "<default>0</default>"
    PHASE_MAP
    "</int>"
    "<int size='1'>"
    "<name>Y Phase</name>"
    "<default>0</default>"
    PHASE_MAP
    "</int>"
    "<string size='2'/>" /* room for more settings */
    "</group>"

    "<group>"
    "<name>Signal Test</name>"
    "<description>From Start until Stop, every chip on the chain, set up or not, lights red, "
    "yellow and green in turn and then none, a second each (outputs R, Y and G, as SSSB heads "
    "are wired). The heads still follow their events, and go back to their aspects at Stop. "
    "Give every node the same pair to test all the chains on the layout at once.</description>"
    "<eventid><name>Start Event</name></eventid>"
    "<eventid><name>Stop Event</name></eventid>"
    "</group>"

    "<group replication='16'>"
    "<name>Own Events</name>"
    "<description>For each output of the head set to Own Events: it lights at its brightness "
    "on its On event and goes out on its Off event, fading if the head fades. Its events are "
    "on the bus while the head is enabled. It starts out dark.</description>"
    OUTPUTS(1) OUTPUTS(2) OUTPUTS(3) OUTPUTS(4) OUTPUTS(5) OUTPUTS(6) OUTPUTS(7) OUTPUTS(8)
    OUTPUTS(9) OUTPUTS(10) OUTPUTS(11) OUTPUTS(12) OUTPUTS(13) OUTPUTS(14) OUTPUTS(15) OUTPUTS(16)
    "<eventid><name>R On</name></eventid>"
    "<eventid><name>R Off</name></eventid>"
    "<eventid><name>G On</name></eventid>"
    "<eventid><name>G Off</name></eventid>"
    "<eventid><name>Y On</name></eventid>"
    "<eventid><name>Y Off</name></eventid>"
    "</group>"
    "</segment>"

    "</cdi>";

const size_t cdi_xml_len = sizeof(cdi_xml); /* includes null terminator */
