mikesmitty/canbus-outpost/test/test_cdi_layout.c

// Checks that every field the CDI describes sits at the address and size
// config_layout.h gives it, so the XML and the struct can't drift apart.
#include <stdio.h>
#include <stdlib.h>
#include <string.h>
#include "app/cdi_data.h"
#include "app/config_layout.h"

typedef enum { KIND_INT, KIND_STRING, KIND_EVENTID } kind_t;

typedef struct {
    unsigned offset;
    unsigned size;
    kind_t kind;
} field_t;

static field_t found[1024];
static int nfound;

static unsigned attr(const char *tag_start, const char *name)
{
    const char *end = strchr(tag_start, '>');
    const char *a = strstr(tag_start, name);
    if (!a || a > end)
        return 0;
    return (unsigned)strtoul(a + strlen(name) + 2, NULL, 10);  // name='N'
}

// Walk the CDI: segments set the address, groups repeat their contents,
// int/string/eventid elements take space.
static void walk(void)
{
    unsigned pos = 0;
    struct { unsigned start; unsigned reps; } groups[4];
    int depth = 0;

    for (const char *p = cdi_xml; (p = strchr(p, '<')) != NULL; p++) {
        if (strncmp(p, "<segment", 8) == 0) {
            pos = attr(p, "origin");
        } else if (strncmp(p, "<group", 6) == 0) {
            unsigned reps = attr(p, "replication");
            groups[depth].start = pos;
            groups[depth].reps = reps ? reps : 1;
            depth++;
        } else if (strncmp(p, "</group>", 8) == 0) {
            depth--;
            unsigned stride = pos - groups[depth].start;
            // Record the remaining replicas' fields by copying the first
            int first = nfound;
            while (first > 0 && found[first - 1].offset >= groups[depth].start)
                first--;
            int n = nfound - first;
            for (unsigned r = 1; r < groups[depth].reps; r++)
                for (int k = 0; k < n; k++) {
                    found[nfound] = found[first + k];
                    found[nfound++].offset += r * stride;
                }
            pos = groups[depth].start + stride * groups[depth].reps;
        } else if (strncmp(p, "<int", 4) == 0 && (p[4] == ' ' || p[4] == '>')) {
            unsigned size = attr(p, "size");
            found[nfound++] = (field_t){ pos, size ? size : 1, KIND_INT };
            pos += size ? size : 1;
        } else if (strncmp(p, "<string", 7) == 0) {
            unsigned size = attr(p, "size");
            found[nfound++] = (field_t){ pos, size, KIND_STRING };
            pos += size;
        } else if (strncmp(p, "<eventid", 8) == 0) {
            found[nfound++] = (field_t){ pos, 8, KIND_EVENTID };
            pos += 8;
        }
    }
}

#define F(member, kind) { offsetof(config_layout_t, member), \
                          sizeof(((config_layout_t *)0)->member), kind }
#define S(member, kind) { offsetof(config_servo_t, member), \
                          sizeof(((config_servo_t *)0)->member), kind }
#define T(member, kind) { offsetof(config_track_t, member), \
                          sizeof(((config_track_t *)0)->member), kind }
#define H(member, kind) { offsetof(config_head_t, member), \
                          sizeof(((config_head_t *)0)->member), kind }
#define L(member, kind) { offsetof(config_head_lamps_t, member), \
                          sizeof(((config_head_lamps_t *)0)->member), kind }

int main(void)
{
    static const field_t node_fields[] = {
        F(user_name, KIND_STRING),
        F(user_description, KIND_STRING),
        F(identify_enabled, KIND_INT),
        F(identify_timeout_minutes, KIND_INT),
    };
    static const field_t servo_fields[] = {
        S(throw_event, KIND_EVENTID),
        S(close_event, KIND_EVENTID),
        S(thrown_feedback, KIND_EVENTID),
        S(closed_feedback, KIND_EVENTID),
        S(center_event, KIND_EVENTID),
        S(thrown_position, KIND_INT),
        S(closed_position, KIND_INT),
        S(center_position, KIND_INT),
        S(throw_time, KIND_INT),
        S(hold_time, KIND_INT),
        S(enabled, KIND_INT),
        S(default_state, KIND_INT),
        S(reversed, KIND_INT),
        S(frog_output, KIND_INT),
        S(fascia_input, KIND_INT),
        S(description, KIND_STRING),
        S(reserved, KIND_STRING),
    };
    static const field_t track_fields[] = {
        T(description, KIND_STRING),
        T(occupied_event, KIND_EVENTID),
        T(clear_event, KIND_EVENTID),
        T(reporter_id, KIND_EVENTID),
        T(orientation, KIND_INT),
        T(reserved, KIND_STRING),
    };
    static const field_t chain_fields[] = {
        F(chain_speed, KIND_INT),
        F(chain_connector, KIND_INT),
        F(chain_reserved, KIND_STRING),
    };
    static const field_t head_fields[] = {
        H(description, KIND_STRING),
        H(aspect_events[0], KIND_EVENTID),
        H(aspect_events[1], KIND_EVENTID),
        H(aspect_events[2], KIND_EVENTID),
        H(aspect_events[3], KIND_EVENTID),
        H(aspect_events[4], KIND_EVENTID),
        H(aspect_events[5], KIND_EVENTID),
        H(aspect_events[6], KIND_EVENTID),
        H(aspect_events[7], KIND_EVENTID),
        H(aspect_events[8], KIND_EVENTID),
        H(aspect_events[9], KIND_EVENTID),
        H(aspect_events[10], KIND_EVENTID),
        H(enabled, KIND_INT),
        H(power_on_aspect, KIND_INT),
        H(output_lamp[0], KIND_INT),
        H(output_lamp[1], KIND_INT),
        H(output_lamp[2], KIND_INT),
        H(output_brightness[0], KIND_INT),
        H(output_brightness[1], KIND_INT),
        H(output_brightness[2], KIND_INT),
        H(lamp_fade, KIND_INT),
        H(chain_position, KIND_INT),
        H(flash_rate, KIND_INT),
        H(output_phase[0], KIND_INT),
        H(output_phase[1], KIND_INT),
        H(output_phase[2], KIND_INT),
        H(reserved, KIND_STRING),
    };
    static const field_t test_fields[] = {
        F(test_start_event, KIND_EVENTID),
        F(test_stop_event, KIND_EVENTID),
    };
    static const field_t lamp_fields[] = {
        L(outputs[0].on_event, KIND_EVENTID),
        L(outputs[0].off_event, KIND_EVENTID),
        L(outputs[1].on_event, KIND_EVENTID),
        L(outputs[1].off_event, KIND_EVENTID),
        L(outputs[2].on_event, KIND_EVENTID),
        L(outputs[2].off_event, KIND_EVENTID),
    };

    field_t want[1024];
    int nwant = 0;
    for (size_t i = 0; i < sizeof(node_fields) / sizeof(node_fields[0]); i++)
        want[nwant++] = node_fields[i];
    for (int s = 0; s < CONFIG_SERVOS; s++)
        for (size_t i = 0; i < sizeof(servo_fields) / sizeof(servo_fields[0]); i++) {
            want[nwant] = servo_fields[i];
            want[nwant++].offset += offsetof(config_layout_t, servos) + s * sizeof(config_servo_t);
        }
    for (int t = 0; t < CONFIG_TRACKS; t++)
        for (size_t i = 0; i < sizeof(track_fields) / sizeof(track_fields[0]); i++) {
            want[nwant] = track_fields[i];
            want[nwant++].offset += offsetof(config_layout_t, tracks) + t * sizeof(config_track_t);
        }
    for (size_t i = 0; i < sizeof(chain_fields) / sizeof(chain_fields[0]); i++)
        want[nwant++] = chain_fields[i];
    for (int h = 0; h < CONFIG_HEADS; h++)
        for (size_t i = 0; i < sizeof(head_fields) / sizeof(head_fields[0]); i++) {
            want[nwant] = head_fields[i];
            want[nwant++].offset += offsetof(config_layout_t, heads) + h * sizeof(config_head_t);
        }
    for (size_t i = 0; i < sizeof(test_fields) / sizeof(test_fields[0]); i++)
        want[nwant++] = test_fields[i];
    for (int h = 0; h < CONFIG_HEADS; h++)
        for (size_t i = 0; i < sizeof(lamp_fields) / sizeof(lamp_fields[0]); i++) {
            want[nwant] = lamp_fields[i];
            want[nwant++].offset += offsetof(config_layout_t, head_lamps) + h * sizeof(config_head_lamps_t);
        }

    walk();

    int failures = 0;
    if (nfound != nwant) {
        printf("FAIL: CDI has %d fields, config_layout.h has %d\n", nfound, nwant);
        failures++;
    }
    for (int i = 0; i < nfound && i < nwant; i++) {
        if (found[i].offset != want[i].offset || found[i].size != want[i].size ||
            found[i].kind != want[i].kind) {
            printf("FAIL: field %d: CDI offset %u size %u, struct offset %u size %u\n", i,
                   found[i].offset, found[i].size, want[i].offset, want[i].size);
            failures++;
        }
    }
    unsigned end = found[nfound - 1].offset + found[nfound - 1].size;
    if (end != sizeof(config_layout_t)) {
        printf("FAIL: CDI ends at %u, struct is %u bytes\n", end, (unsigned)sizeof(config_layout_t));
        failures++;
    }
    if (cdi_xml[cdi_xml_len - 1] != '\0') {
        printf("FAIL: CDI space must end with a NUL\n");
        failures++;
    }
    if (strstr(cdi_xml, "</map><default>")) {
        printf("FAIL: the CDI schema wants <default> before <map>\n");
        failures++;
    }

    printf("cdi layout: %d fields checked, %d failed\n", nfound, failures);
    return failures != 0;
}
