mikesmitty/canbus-outpost/(commit log)

2025-09-01 feat: initial commit
    [54602-908LF.stp, bom.csv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]
2025-09-01 fix: update part rotations
    [canbus-outpost-CmtUser.gbr, canbus-outpost-CuBottom.gbl, canbus-outpost-CuTop.gtl, canbus-outpost-EdgeCuts.gm1, canbus-outpost-MaskBottom.gbs, canbus-outpost-MaskTop.gts, canbus-outpost-NPTH-drl_map.gbr, canbus-outpost-NPTH.drl]
2026-03-29 fix: switch from LM393 to TLV3202 for railcom signals
    [canbus-outpost.kicad_sch]
2026-03-30 feat: add initial firmware implementation for canbus-outpost
    - Initialize C/C++ firmware project for RP2350
    - Integrate OpenLcbCLib and can2040 libraries
    - Add RailCom UART PIO implementation
    - Setup VS Code configuration and CMake build system
2026-03-30 fix: Correct RailCom PIO timing and implement cutout-based gating
    - Adjusted PIO UART loop to exactly 10 cycles per bit.
    - Removed redundant push in PIO (relying on autopush).
    - Implemented cutout synchronization using Pin B for each channel.
    - Added FIFO clearing at the start of the cutout to eliminate DCC noise.
    - Fixed pin assignment confusion (Pin A is Data, Pin B is Cutout).
    [railcom.c]
2026-04-05 feat(firmware): implement LCC servo switch controller with FreeRTOS
    Replace OpenLcbCLib/OpenMRN dependencies with a pure C LCC protocol
    stack. Implement complete LCC node with alias allocation, protocol
    responses (Verify Node ID, PIP, SNIP, Events), event-driven servo
    control, GridConnect USB bridge, and flash config persistence.
    Architecture: 4 FreeRTOS tasks (lcc, can_tx, gc, heartbeat) with
    queue-based inter-task communication. CAN bus via can2040 on PIO1
    at 125kbps. USB CDC GridConnect for JMRI connectivity.
    [canbus-outpost.c, cdi_data.c, gridconnect.c, gridconnect.h, lcc.c, lcc.h, lcc_defs.h]
2026-04-07 feat(firmware): add LCC CDI configuration and servo control enhancements
    Move firmware from firmware/canbus-outpost/ to repo root. Add full LCC
    Memory Configuration Protocol support with CDI XML for JMRI
    configurability. Implement smooth servo interpolation with configurable
    throw time (default 3s), hold timer with PWM power-off, feedback event
    production, and per-servo enable/disable/reverse settings.
    Key changes:
    - Memory Config protocol: datagram reassembly, CDI/config space read/write
    - CDI XML with 4 servo groups (events, positions, timing, enable)
    - Servo driver rewrite: smooth movement, hold countdown, 0% duty power-off
    - Servo tick integrated into lcc_task (20ms loop, no FreeRTOS ti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
    [board.h, can2040.c, canbus-outpost.c, cdi_data.c, gridconnect.c]
2026-04-07 feat(lcc): broadcast switch state on startup
    Emit Producer Identified events for all enabled servos after alias
    allocation so JMRI and other nodes know the current switch positions
    at boot.
2026-04-09 feat(firmware): add identify LED driver and release-please versioning
    Replace heartbeat LED with configurable identify LED that blinks on LCC
    Verify Node ID and SNIP requests, with CDI-configurable timeout. Bump
    config magic to 0x03 for new identify config struct. Update SNIP/CDI
    manufacturer and model naming. Add git-describe-based firmware versioning
    and release-please configuration for automated releases.
    [board.h, canbus-outpost.c, cdi_data.c, identify_led.c, identify_led.h, lcc.c, lcc.h, lcc_memconfig.c]
2026-04-10 fix(lcc): correct Update Complete command and fix flash writes
    LCC_MEMCFG_UPDATE_COMPLETE was defined as 0x08 instead of the correct
    0xA8 per the OpenLCB Memory Configuration spec, so JMRI's Update
    Complete command was unrecognized and config was never persisted to
    flash. Also add pico_flash library and disable multicore lockout
    (PICO_FLASH_SAFE_EXECUTE_PICO_SUPPORT_MULTICORE_LOCKOUT=0) since the
    firmware runs single-core FreeRTOS — flash_safe_execute was timing out
    trying to lock core 1. Adds reboot and factory reset command handlers.
    [lcc.c, lcc.h, lcc_defs.h, lcc_memconfig.c]
2026-04-10 feat(servo): add "No Change" default state option and default to closed
    Add a "No Change" option for servo default state that skips moving the
    servo at power-on and reports unknown state until the first throw/close
    event. Change the factory default from thrown to closed. Bump config
    magic to invalidate old flash configs due to semantic changes.
    [canbus-outpost.c, cdi_data.c, lcc.c, lcc.h]
2026-10-16 fix(hardware): fix railcom circuits
2026-10-16 feat(lcc): add standalone OpenLCB library with host tests
    Plain C11 implementation of the LCC node protocols with no SDK, RTOS or
    heap dependencies: frames go out through a send hook and time comes in
    as a millisecond counter.
    - CAN frame transfer: alias allocation, alias defense, duplicate-alias
    recovery (AMR), Alias Map Enquiry
    - Verify Node ID, Protocol Support, SNIP, Optional Interaction Rejected
    - Event producer/consumer registry with identify replies
    - Datagrams: reassembly, busy and out-of-order rejection, resend on
    temporary rejection
    - Memory configuration: read/write, space info, options, lock, update
    complete, reboot, factory reset
    - GridConnect codec
    Host tests run with `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
2026-10-16 feat(firmware): rebuild the node on the LCC library
    Restructure the firmware around one LCC task that owns the library, the
    configuration and the application state; other tasks and interrupts
    hand it work through a queue.
    - Store the configuration space in OpenLCB byte order so values set in
    JMRI read back correctly (multi-byte fields were byte-swapped)
    - Drive servo motion from a 20 ms timer rather than the LCC task's
    wakeups, so bus traffic no longer changes servo speed
    - Power-safe two-sector flash records with CRC for the configuration
    and the node ID
    - Set a per-board node ID with the `nodeid` USB console command
    - Event-driven USB GridConnect, CAN transmit and debounced fascia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
2026-10-16 feat(railcom): report occupancy and locomotives over LCC
    Each track gets a RailCom Detectors CDI group with an Occupied/Clear
    event pair and locomotive reports in the OpenLCB DCC detector format
    (a 64K event range per track for JMRI reporters: entry with West/East/
    unknown orientation, exit, and short/long/consist addresses), answering
    Identify Producer per the draft rules. Orientation is off by default
    until the wiring's Rail A is set. Default reporter IDs are the four
    unique IDs after the node ID and move with it, like default events.
    The detector now holds track states while cutouts are missing (track
    power off) instead of reporting every track vacant, and reports each
    empty track once v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
2026-10-16 feat(firmware): add LCC firmware upgrades with A/B partitions
    partition_table.json splits flash into two app partitions and leaves
    the top 16 KB (configuration and node ID) outside them; install it once
    per board with `make partition-table`. An upgrade from an LCC tool
    (e.g. JMRI Firmware Update with canbus-outpost.bin) is written to the
    partition not running, checked for completeness from its picobin block
    loop, and started with a flash-update boot.
    Images are built try-before-you-buy with a SHA-256 hash: a new image
    confirms itself 5 s after the node comes up, and one that resets first
    or isn't confirmed within 60 s is dropped for the previous image.
    nv_storage now reads at physical flas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
2026-10-16 ci: test and build every push with pinned toolchain and SDKs
    A shared setup action installs the Arm toolchain and Pico SDK at the
    versions in CMakeLists.txt and FreeRTOS-Kernel at a fixed commit, all
    cached; the release build used to clone the SDK's master branch. The
    CI workflow runs the host tests, builds the firmware, checks the image
    is fit for LCC upgrades and keeps it as an artifact. Releases also
    attach the .bin for LCC firmware upgrades.
    Drop .gitmodules: it named a submodule that no longer exists.
    Claude-Session: https://claude.ai/code/session_01GnQkt17N1DG4n4wfMXZFhe
2026-10-16 docs(claude): describe firmware upgrades and RailCom events
    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
2026-10-16 feat(lcc): detect another node using this node's ID
    After claiming its alias the node sends Verify Node ID with its own ID,
    which only a duplicate answers, and it watches for Verified Node ID,
    Initialization Complete or AMD frames carrying its ID from another
    alias. The first one produces the well-known Duplicate Node ID Detected
    event and calls a new duplicate_node_id hook so the application can
    show it.
    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
2026-10-16 fix(node-id): keep the stand-in node ID out of other vendors' ranges
    The stand-in used until a node ID is assigned was the low 6 bytes of the
    chip ID, so its first byte could fall in manufacturer, assigned,
    locomotive or reserved ranges. Use the locally-allocated range instead
    (0A prefix, Unique Identifiers Standard 5.12) with the low 40 bits of
    the chip ID, which can't collide with globally unique IDs.
    The nodeid command now refuses IDs starting 00 or FF, which the
    standard reserves. A duplicate node ID found by the LCC library is
    logged, printed on the USB console and shown by fast-blinking the
    identify LED until reboot.
    Claude-Sess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
2026-10-16 chore(hardware): add misc kicad files
2026-10-17 fix(lcc): release the alias before rebooting
    No reboot sent Alias Map Reset, so other nodes kept a stale mapping for
    our alias: memory configuration Reboot, factory reset, Unfreeze of a
    good image, the nodeid command and a new image timing out on trial.
    lcc_reboot() sends AMR and then keeps the node silent, ignoring the bus
    and dropping sends such as RailCom reports, which don't check whether
    the node is initialized. The existing 100 ms reboot delay lets the AMR
    go out with the replies. The application's own reboots go through it
    too, with the time passed in since the library's clock can be stale.
    Claude-Session: https://claude.ai/cod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
2026-10-27 fix(servo): stop the PWM after the hold time on instant moves
    A move that arrives at once (throw time 0, already at the target, or
    the move to the default state at boot) never started the hold
    countdown, so the servo was driven forever whatever the hold time.
    Every servo stayed powered from boot on.
2026-10-27 fix(usb): fit the longest console messages
    The 96-byte buffer cut off the duplicate node ID warning and the
    nodeid confirmation, along with their newlines.
2026-10-27 fix(can): resend a transmit halted by can2040's rx stall recovery
    A flash erase or program turns interrupts off for tens of milliseconds,
    long enough for can2040's rx FIFO to overflow. Its recovery resets the
    PIO state machines, which leaves the "tx" state machine disabled with
    the pending frame still in its FIFO. pio_tx_did_fail() didn't treat
    that as a failed attempt, so the transmit was never rescheduled, and
    the node stopped sending on CAN until it was reset.
    On the bench this happened within a few config saves (Update Complete)
    while the node was sending on CAN, and on most firmware upgrades over
    USB, which then took about 220 s instead of 16 s. With the fix, 100
    saves under load went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
2026-10-27 fix(config): save configuration writes without waiting for Update Complete
    Configuration writes applied at once but reached flash only on Update
    Complete, so a tool that didn't send it lost every change at the next
    power cycle. The Memory Configuration Standard (4.23) says nodes don't
    have to require Update Complete; tools should send it, but many nodes
    save on every write, so tools tested against them work without it.
    Writes are now saved a second after the last one, so a tool's run of
    writes is one flash save. Update Complete and reboot save any pending
    writes at once. A save that matches what's already in flash skips the
    erase, along with its time with interrupts off.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
2026-10-29 chore: footprint path bugfix
2026-10-31 feat: add SSSB LED signal header
2026-10-31 feat(signals): drive SSSB signal heads over LCC
    Add the WS2811 chain on J15, PIO2 with DMA at 400 or 800 kHz, and up to 16
    signal heads, a head being one chip. Each output takes any lamp, including
    the lunar, S, D and speed number lights of NYC subway signals, and each
    lamp has an aspect event, as do flashing red, yellow and green and dark.
    The node has no mast logic: the host sends each head its aspect, and heads
    hold it until told otherwise. Heads start disabled, and only the aspects
    an enabled head can show are on the bus. The new configuration goes at the
    end of the layout, so saved configurations still load.
    Claude-Session: https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
2026-10-31 feat(lcc): deliver a node's own events to its consumers
    A node doesn't hear its own frames, so an event ID shared by a producer and
    a consumer on one board did nothing: a head couldn't follow a turnout on the
    same outpost. Queue each event sent and run this node's consumers on the
    next run of the timers.
    Delivery waits rather than happening inside lcc_event_send because callers
    may be part way through a change, and an event wired back to itself would
    otherwise recurse until the stack overflowed. Each run delivers only what
    was queued when it started, so a link like that can't starve the LCC task.
    Claude-Session: https://claude.ai/code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
2026-10-31 docs(readme): describe the board and its signal heads
    The README was only a title. Cover what the board does, how to build and
    flash it, and how to set up signal heads, including what a host has to
    do for them and that the chain hasn't been run on hardware yet.
    Claude-Session: https://claude.ai/code/session_01HpTxyvA3XvecnQH2c4spF4
2026-11-07 docs(readme): note that RR-CirKits' heads run at 800 kHz on 5 V
    RR-CirKits' head boards leave the WS2811's SET pin open, so they run at
    800 kHz, the Chain Speed default. They carry nothing but the chip, its
    decoupling capacitor and 33 ohm resistor networks, with no resistor on
    VDD that would let them run from 12 V, so they take the 5 V that J15
    supplies.
    Claude-Session: https://claude.ai/code/session_01HpTxyuwrp5JcLUCA5NWpTp
2026-11-07 feat(signals): let a servo output carry the signal chain
    Boards made before the LED header have nowhere to plug in signal heads.
    A new Signal Heads setting, Connected To, puts the WS2811 chain on one
    of the servo outputs instead, through a 5 V buffer on the data line.
    That servo's switch machine then acts as disabled, and moving the chain
    away gives the pin back to its servo. The chain changes pins only
    between frames.
    The setting takes a reserved byte, so saved configurations read it as
    the LED header.
    User-facing text now calls J15 the LED header, as the silkscreen does.
    Claude-Session: https://claude.ai/code/session_01HpTxyuwrp5Jc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
2026-11-07 feat(hardware): add sssb-single signal head board
    A board for one SSSB head: a WS2811 with IN and OUT headers in servo
    cable order (S, +, -, as on the LED header) and an RGY header for a
    common-anode head. SET is open, so it runs at 800 kHz.
    R1 (33 ohm) feeds DIN by default. For the first head on a servo output
    of a board made before the LED header, fit U1 (74AHCT1G125) and C2
    instead, never both, so the head buffers its own input to 5 V.
    production/ is what was ordered from JLCPCB, regenerated after adding
    the U2 rotation correction; the gerbers are unchanged.
    Claude-Session: https://claude.ai/code/session_01HpTxyuwrp5JcLUCA5NWpTp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
2026-11-09 feat(signals): add lamp fade, chain positions and a signal test
    Three features from RR-CirKits' Signal LCC-32H:
    - Lamp Fade: a head set to Incandescent warms its lamps up over 150 ms
    and cools them over 300 ms, flashing included, with the output
    following heat squared so the ramp looks even.
    - Chain Position: a head can sit on any chip of the chain, so a chip
    added partway along means moving the heads after it rather than
    setting them up again. 0, as in older saved configurations, is the
    head's own number. Both settings use spare bytes in the head group.
    - Signal test: from a Start event until a Stop event, every chip on the
    chain lights red, yellow and green in turn, then none,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
2026-11-13 ci(hardware): version boards separately and stamp KiCad rev and date
    Each board is now its own release-please package (outpost-board, starting
    at 0.4.0 after three unversioned orders, and sssb-single at 0.1.0), and the
    firmware package leaves hardware/ out. A board's release pull request
    writes its version into the title block revision of its schematic and PCB,
    which the outpost board prints on its silkscreen.
    A push to main that changes a schematic or PCB gets its title block date
    set to the day of the file's last commit that changed more than the title
    block, so release revisions and the date commits don't count as edits.
    Adds a title block to sssb-single and backfills both boards' dates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
2026-11-13 chore(main): release sssb-single 0.1.0 (#15)
    * chore(main): release sssb-single 0.1.0
    * chore(hardware): set KiCad revision to v0.1.0
    ---------
2026-11-13 chore(main): release outpost-board 0.4.0 (#16)
    * chore(main): release outpost-board 0.4.0
    * chore(hardware): set KiCad revision to v0.4.0
    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
2026-11-13 feat(storage): keep settings in the top 64 KB of flash
    Partition B now ends 64 KB short of the top of flash (partition table
    version 1.1). The configuration gets two 16 KB slots there, 16 KB stays
    spare, and the node ID keeps its place. A record can span several
    sectors, written last sector first, so a power cut never leaves a new
    header ahead of its data.
    Boards on the old table keep working, with the configuration in its old
    4 KB slots; once they have the new table it moves across on its next
    save.
    Claude-Session: https://claude.ai/code/session_01HpTxyyJdZTvmak1REaGPx1
2026-11-13 feat(signals): add flash rates, phases and own-event outputs
    A head flashes slow (40 a minute), medium (60, the default and the old
    rate) or fast (90), and each output flashes in phase A or B, for
    alternating flashers. Heads flashing at one rate flash together.
    An output set to Own Events leaves the aspects and follows an On/Off
    event pair of its own, for panel or building lights. A head with only
    such outputs puts no aspects on the bus.
    A head's outputs are now named R, G and Y, after the head board's RGY
    header, in place of the WS2811 pin names. The LCC library's event limit
    defaults to 512.
    Claude-Session: https://claude.ai/code/s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
2026-11-13 feat(firmware): install the partition table with upgrades over CAN
    The firmware carries the partition table from partition_table.json,
    made with picotool at build time. Once an image is confirmed, a board
    whose table is older gets the new one in the boot ROM's other partition
    table slot, and the next boot uses it, since the boot ROM takes the
    valid table with the higher version. The table in use is never touched,
    so a power cut while writing leaves the board on it, and the next boot
    tries again.
    Boards set up before the 64 KB storage area get its table this way,
    without USB.
    Claude-Session: https://claude.ai/code/session_01HpTxyyJdZTv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
2026-11-13 fix(build): take the firmware version from the firmware's tags
    git describe picked up the boards' release tags (sssb-single-v0.1.0,
    outpost-board-v0.4.0), so the version in SNIP named a board release.
    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
